hah877298-a11y/STM32F103_Attitude_Servo_System/Docs/verification_photos/04_oled_runtime.png.jpg

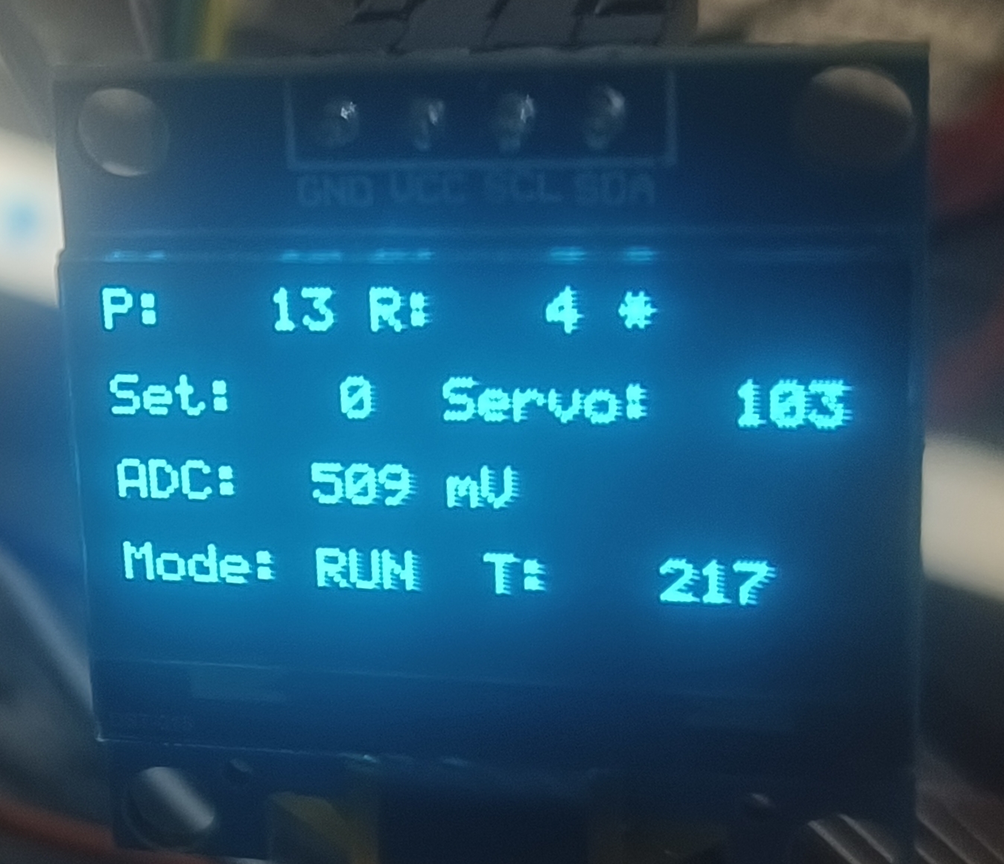
Docs/verification_photos/04_oled_runtime.png.jpg
