hah877298-a11y/STM32F103_Attitude_Servo_System/Docs/algorithm_analysis.md

# 算法原理与对比分析

## 1. 姿态解算: 互补滤波与卡尔曼滤波

### 1.1 问题定义

MPU6050 提供两类独立的姿态信息来源:

| 传感器 | 物理量 | 获取姿态的方式 | 误差特性 |
|---|---|---|---|
| 加速度计 | 比力 (含重力分量) | 反正切直接求角度 | 静态准确，动态受振动/加速度干扰 |
| 陀螺仪 | 角速度 | 积分求角度增量 | 动态响应快，长期积分漂移 |

单传感器均无法独立提供可靠姿态。需要融合算法。

### 1.2 一阶互补滤波

**传递函数:**

$$
\theta(s) = \frac{\alpha}{s + \alpha} \cdot \theta_{accel}(s) \;+\; \frac{s}{s + \alpha} \cdot \frac{\omega_{gyro}(s)}{s}
$$

第一项为加速度计角度的低通滤波 (截止频率 $\alpha$ rad/s)，第二项为陀螺仪角速度的高通滤波。两者在频域上互补，覆盖全频段。

**离散化实现 (前向欧拉):**

$$
\theta[k] = \alpha \cdot (\theta[k-1] + \omega[k] \cdot \Delta t) \;+\; (1-\alpha) \cdot \theta_{accel}[k]
$$

**参数选取:**

$\alpha$ 决定陀螺仪的信任权重。时间常数 $\tau = \frac{\alpha \cdot \Delta t}{1-\alpha}$。

| α 值 (Δt=10ms) | τ | 特性 |
|:---:|:---:|---|
| 0.96 | 0.24s | 响应快，适合高动态 |
| 0.98 | 0.49s | **本工程采用**，平衡响应与平滑 |
| 0.99 | 0.99s | 平滑但响应滞后 |

**计算复杂度:** 3 次浮点乘 + 2 次浮点加 / 轴。双轴约 10 条指令，在 STM32F103 (72MHz, 无硬件 FPU) 上约 40µs。

### 1.3 卡尔曼滤波

**状态空间模型 (线性化):**

状态向量 $\mathbf{x} = [\theta, \dot{\theta}_{bias}]^T$ (角度 + 陀螺零偏)。

预测步骤:
$$
\hat{\mathbf{x}}_k^- = \mathbf{A}\hat{\mathbf{x}}_{k-1} + \mathbf{B}u_k, \quad
\mathbf{P}_k^- = \mathbf{A}\mathbf{P}_{k-1}\mathbf{A}^T + \mathbf{Q}
$$

更新步骤:
$$
\mathbf{K}_k = \mathbf{P}_k^-\mathbf{H}^T(\mathbf{H}\mathbf{P}_k^-\mathbf{H}^T + \mathbf{R})^{-1}
$$
$$
\hat{\mathbf{x}}_k = \hat{\mathbf{x}}_k^- + \mathbf{K}_k(z_k - \mathbf{H}\hat{\mathbf{x}}_k^-)
$$
$$
\mathbf{P}_k = (\mathbf{I} - \mathbf{K}_k\mathbf{H})\mathbf{P}_k^-
$$

**核心优势:**
- 增益 $\mathbf{K}_k$ 随噪声统计特性 ($\mathbf{Q}, \mathbf{R}$) 自适应调节
- 可同时估计陀螺零偏，消除积分漂移的根源
- 在模型准确且噪声为高斯白噪声时，为最小均方误差意义下的最优估计

**计算复杂度:** 2×2 矩阵运算，约 50 次浮点乘加。在 STM32F103 上约 200µs，约为互补滤波的 5 倍。

### 1.4 选型依据

| 维度 | 互补滤波 | 卡尔曼滤波 |
|---|---|---|
| 计算量 | 极低 | 中等 |
| 调参 | 1 参数 (α) | 2 协方差矩阵 (Q, R) |
| 偏置估计 | 不支持 | 支持 |
| 精度 | 静态 ±0.5°, 动态 ±2° | 静态 ±0.1°, 动态 ±0.5° |
| 适用 MCU | Cortex-M0/M3 无 FPU | Cortex-M4F+ 有 FPU |
| 工业应用 | 消费级云台、玩具 | 无人机飞控、自动驾驶 |

**本工程选型结论:** STM32F103C8T6 无硬件 FPU，互补滤波以 5% 的计算开销达到卡尔曼滤波约 80% 的姿态精度，是工程上合理的取舍。若升级至 STM32F4/G4 系列，可引入卡尔曼滤波获取偏置估计能力。

---

## 2. PID 控制器: 位置式与增量式

### 2.1 位置式 PID

**公式:**
$$
u(k) = K_p e(k) + K_i \sum_{i=0}^{k} e(i)\Delta t + K_d \frac{e(k) - e(k-1)}{\Delta t}
$$

**输出含义:** 控制量的绝对值 (本工程中为舵机目标角度 0~180°)。

**积分饱和 (Integral Windup):**

当执行器达到物理极限 (如舵机转到 180°) 而偏差仍存在时，积分项持续增长。偏差反向时，需要长时间"泄放"积分值，导致严重超调。

**对策 — 积分限幅 (Clamping):**
$$
\text{if } |\int e| > I_{limit} \text{ then } \int e = \text{sgn}(\int e) \cdot I_{limit}
$$

本工程设定 $I_{limit} = 20.0$，对应约 0.4s 满偏持续时间的积分累积。

### 2.2 增量式 PID

**公式:**
$$
\Delta u(k) = K_p [e(k)-e(k-1)] + K_i e(k)\Delta t + K_d [e(k)-2e(k-1)+e(k-2)]/\Delta t
$$
$$
u(k) = u(k-1) + \Delta u(k)
$$

**输出含义:** 控制量的变化量 (适用于步进电机脉冲频率、PWM 占空比增量等)。

**天然优势:**
- 积分项仅作用于当前偏差 $e(k)$，不存在无限累积，无需抗饱和
- 手动/自动切换时 $\Delta u = 0$，输出不突变 (无扰切换)
- 单次计算错误仅影响一个增量，下一周期自动修正

### 2.3 对比总结

| 维度 | 位置式 | 增量式 |
|---|---|---|
| 输出语义 | 绝对值 | 增量 |
| 积分处理 | 需手动限幅 | 天然防饱和 |
| 无扰切换 | 需清零积分 | 天然支持 |
| 状态记忆 | $e(k-1)$ | $e(k-1), e(k-2), u(k-1)$ |
| 典型执行器 | 舵机、伺服、阀门 | 步进电机、加热器 |
| 故障恢复 | 需重新初始化 | 断点续传 |

**本工程选型结论:** SG90 舵机控制接口为绝对角度值 (0~180°)，位置式 PID 的物理意义直接匹配。通过积分限幅解决饱和问题，在切换设定值时自动清零积分 (PID_SetSetpoint 内实现) 以避免过冲。

---

## 3. I2C 总线协议

### 3.1 物理层

I2C 使用两条开漏 (Open-Drain) 信号线:

- **SCL (Serial Clock):** 主机驱动时钟
- **SDA (Serial Data):** 双向数据，由当前发送方驱动

**开漏输出的必要性:**

| 特性 | 推挽输出 | 开漏输出 |
|---|---|---|
| 多设备共享总线 | 不可 (短路风险) | 支持 (线与逻辑) |
| 从机应答 (第 9 位) | 主机强驱，从机无法拉低 | 主机释放，从机可控 |
| 多主机仲裁 | 不支持 | 支持 (检测 SDA 冲突) |
| 电平转换 | 需额外电路 | 上拉到目标电压即可 |

**上拉电阻计算:**

总线速率 100kHz 时，上升时间 $t_r \leq 1000\text{ns}$。总线电容 $C_b \leq 400\text{pF}$ (标准模式)。

$$
R_{pull-up} \approx \frac{t_r}{0.847 \cdot C_b} \approx \frac{1000\text{ns}}{0.847 \cdot 400\text{pF}} \approx 2.95\text{k}\Omega
$$

受输出驱动能力 ($I_{OL} = 3\text{mA}$) 下限约束:
$$
R_{min} = \frac{V_{DD} - V_{OL}}{I_{OL}} \approx \frac{3.3 - 0.4}{0.003} \approx 967\Omega
$$

因此 $1\text{k}\Omega < R_{pull-up} < 3\text{k}\Omega$。实际常用 $4.7\text{k}\Omega$ (多个设备并联时等效电阻下降，仍在可用范围)。

### 3.2 时序协议

**四种核心信号:**

```
Start:  SCL=1 期间 SDA 下降沿  (1→0)
Stop:   SCL=1 期间 SDA 上升沿  (0→1)
Data:   SCL=0 期间 SDA 可变化, SCL 上升沿采样
ACK:    第 9 个 SCL, SDA=0 → ACK, SDA=1 → NAK
```

**读取多字节序列:**
```
[S]→[Addr+W]→[RegAddr]→[S]→[Addr+R]→[Data0→ACK]→[Data1→ACK]→...→[DataN→NAK]→[P]
```

最后一个字节主机回复 NAK，从机收到后释放总线。

### 3.3 软件模拟与硬件外设对比

| 维度 | 软件 I2C (本工程) | 硬件 I2C (STM32F1) |
|---|---|---|
| 引脚 | 任意 GPIO | 固定复用引脚 |
| 传输期间 CPU | 忙等 (bit-banging) | 中断/DMA 释放 CPU |
| 时钟拉伸 | 天然支持 | 需配置 CR1.NOSTRETCH |
| BUSY 位锁死 | 不存在 | STM32F1 已知问题 |
| 调试透明度 | 完全可控，逻辑分析仪可见 | 状态机内部不可见 |
| 最大速率 | ~100kHz (受 GPIO 翻转限制) | 100/400kHz |
| 代码体积 | ~200 行 | ~50 行 (库函数) |

**本工程选用软件 I2C 的技术理由:**

1. GPIO 灵活性 — 可使用 PB10/PB11，避开被占用的硬件 I2C 引脚
2. 可靠性 — STM32F1 系列硬件 I2C 在从机异常时可能出现 BUSY 位永久锁死，需复位外设才能恢复；软件模拟无此问题
3. 多从机 — 同一条总线同时挂载 MPU6050 (0x68) 和 OLED (0x3C)，地址不冲突即可直接通信
4. 可观测性 — 调试阶段用逻辑分析仪可清晰看到每个 bit 的时序

### 3.4 时钟拉伸 (Clock Stretching)

从机在 SCL 上升沿后若未准备好数据，可保持 SCL 为低电平，主机需等待 SCL 真正变高后再采样:

```
主机: 释放 SCL, 期望上升沿 → 等待 → 检测到 SCL 仍为低
从机: 保持 SCL 低, 准备数据中 → 数据就绪 → 释放 SCL
主机: 检测到 SCL 变高 → 采样数据
```

软件 I2C 通过 `while(SCL==LOW)` 等待天然支持此机制。硬件 I2C 需设置 CR1 寄存器使能，且部分旧版 STM32F1 芯片的时钟拉伸支持存在硬件缺陷。
