hah877298-a11y/STM32F103_Attitude_Servo_System/Docs/verification_photos/02_boot_log.png

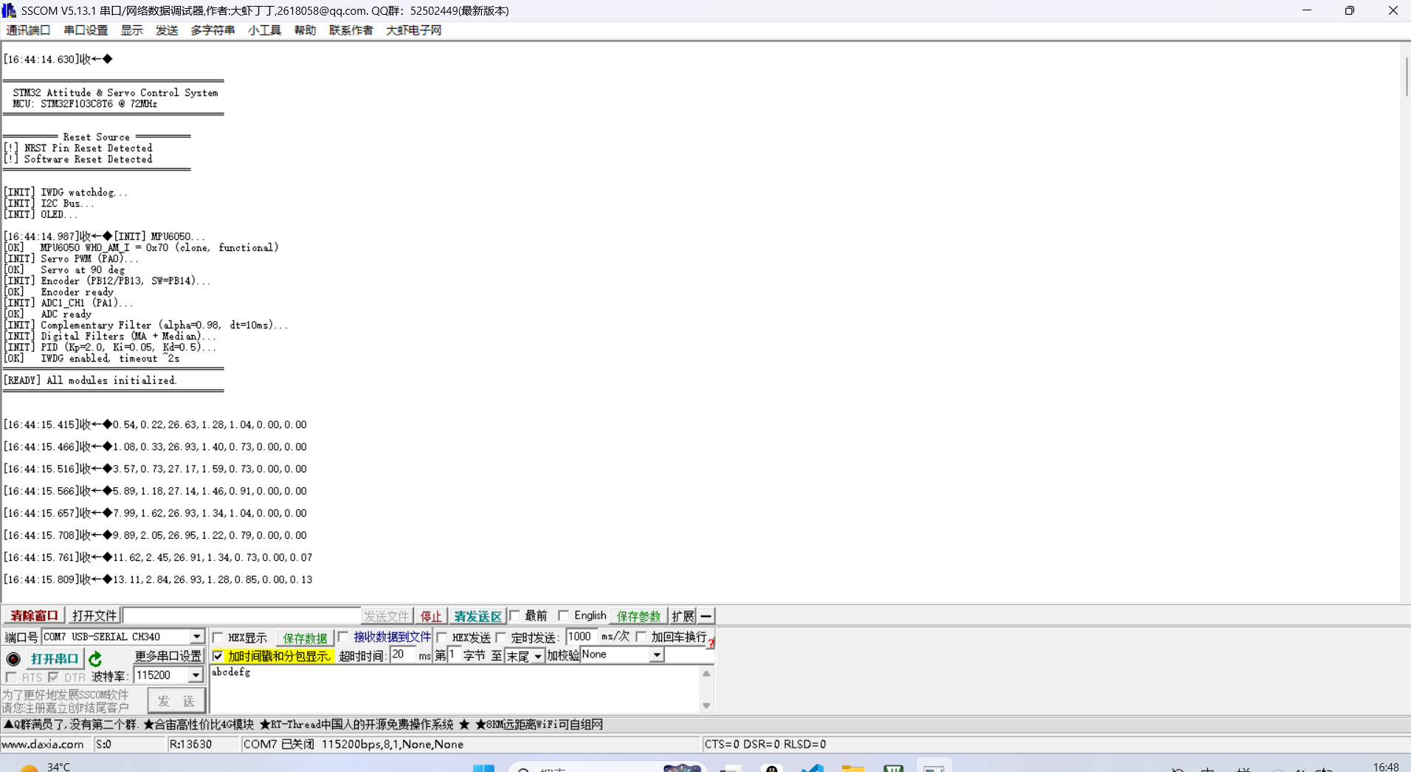
Docs/verification_photos/02_boot_log.png
