hah877298-a11y/STM32F103_Attitude_Servo_System/Docs/verification_photos/05_vofa_waveform_debug.png

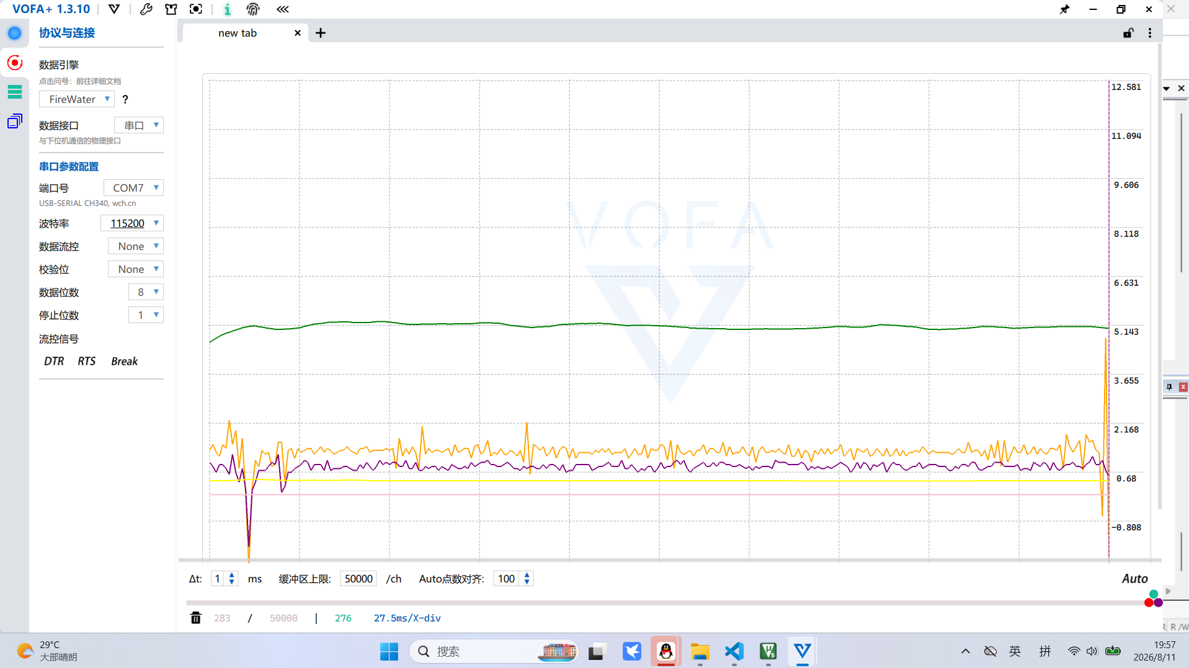
Docs/verification_photos/05_vofa_waveform_debug.png
