hah877298-a11y/STM32F103_Attitude_Servo_System/(commit log)

2026-08-04 feat: STM32 attitude acquisition and servo control system
    - 5-channel non-blocking scheduler (10/20/50/200/1000ms)
    - Software I2C (PB10/PB11) for MPU6050 + OLED
    - First-order complementary filter (alpha=0.98)
    - Position PID controller with anti-windup
    - SG90 servo PWM (TIM2_CH1, PA0, 50Hz)
    - EC11 encoder with EXTI (PB12/PB13) + SW button (PB14)
    - ADC1_CH1 analog sensor (PA1)
    - USART1 + DMA + VOFA+ JustFloat (7 channels, 20Hz)
    - IWDG watchdog (~1s timeout)
    - Encoder-based online PID tuning (Kp/Ki/Kd)
    - 0 Error, 0 Warning on ARMCC V5.06
    Hardware: STM32F103C8T6 @ 72MHz
    Flash: ~18KB, RAM: ~1.3KB
    [Encoder.c, Encoder.h, Filter.c, Filter.h, MPU6050.c, MPU6050.h, OLED.c, OLED.h]
2026-08-04 refactor: convert all comments to industrial Doxygen format
    - Replace verbose educational banners with @file/@brief/@param/@return
    - Remove tutorial text, ASCII diagrams, self-Q&A annotations
    - Keep functional comments: pin numbers, register values, timing constants
    - Preserve code logic, function signatures, and string literals
    [Encoder.c, Encoder.h, Filter.c, Filter.h, MPU6050.c, MPU6050.h, OLED.c, OLED.h]
2026-08-13 feat: OLED framebuffer, IWDG watchdog, scheduler refactor, and verification archive
    - OLED: 1KB RAM framebuffer with page-flush scheduling; Task_1000ms rebuilds
    the frame in microseconds, page 0/2/4/6 pushed per 200ms tick (~50ms each)
    - IWDG: 2s timeout fed in Scheduler_Run; DBGMCU freezes the watchdog at
    breakpoints; reset-source logged at boot
    - Filter chain: complementary -> moving average (8) -> rate limiter (5 deg)
    -> median (5), parameters centralized in system_config.h
    - Scheduler: task_scheduler extracted to USER/App, all comments converted
    to English Doxygen format
    - Cleanup: removed unused spi/w25q64 template drivers and dead code
    - Docs: architecture.md, debugging_guide.m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
    [Encoder.c, Encoder.h, Filter.c, Filter.h, MPU6050.h, OLED.c, OLED.h, Servo.c]
